perxeux0/TIMBRE_VER_2/hardware/caja_timbre_v1.stl

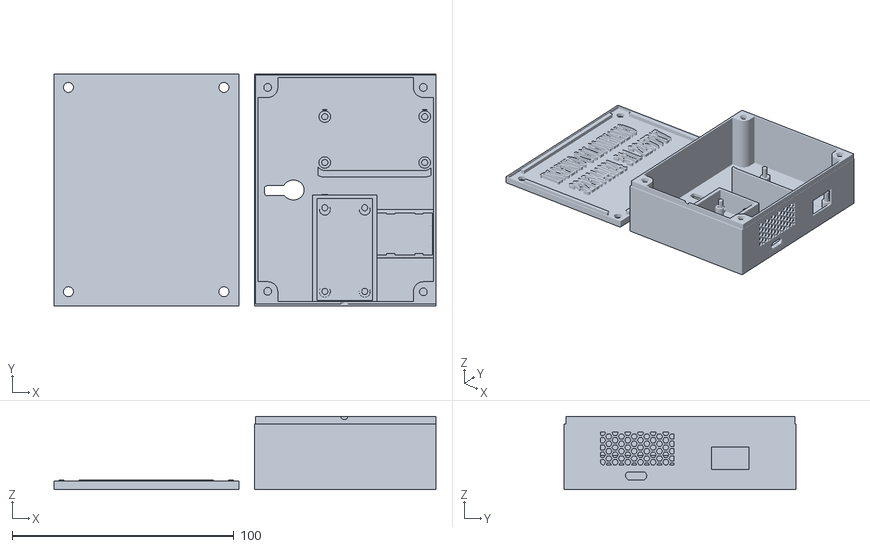
[picture p1: CAD file, 2026-10-14]
hardware/caja_timbre_v1.stl
172.4 x 104.6 x 33.0
