perxeux0/TIMBRE_VER_2/firmware/Timbre_Alba_V2/web_assets.h

#pragma once
// ARCHIVO GENERADO por tools/build_web.py - no editar a mano.
// Fuente: carpeta web/ (index.html, app.css, app.js)
#include <Arduino.h>
static const char WEB_ETAG[] = "\"5afd2a3bb6286d9f\"";

static const uint8_t WEB_INDEX_GZ[] PROGMEM = {
  0x1f,0x8b,0x08,0x00,0x00,0x00,0x00,0x00,0x02,0xff,0xb5,0x58,0xc1,0x6e,0xdc,0x36,0x10,0xbd,0xfb,0x2b,
  0x18,0xf6,0x6a,0x79,0x6d,0x37,0x28,0x7a,0xd0,0x6e,0x61,0x18,0x68,0xd1,0xa2,0x2d,0x82,0xba,0x45,0xcf,
  0x94,0x34,0xde,0x65,0x4d,0x91,0x0a,0x49,0xad,0xb3,0xf9,0xa3,0x1e,0x7a,0x08,0x72,0x28,0x90,0x63,0xfd,
  0x63,0x7d,0x23,0x4a,0x2b,0x69,0xbd,0x49,0x9a,0xd6,0x3d,0xc4,0x5a,0x92,0xc3,0xe1,0xcc,0x9b,0x99,0x37,
  0x64,0xf2,0x67,0x95,0x2b,0xe3,0xae,0x21,0xb1,0x89,0xb5,0x59,0x9d,0xe4,0xfc,0x11,0x46,0xd9,0xf5,0x52,
  0x52,0x90,0x3c,0x41,0xaa,0xc2,0xa7,0xa6,0xa8,0x44,0xb9,0x51,0x3e,0x50,0x5c,0xca,0x36,0xde,0x66,0x5f,
  0xca,0x61,0xda,0xaa,0x9a,0x96,0x72,0xab,0xe9,0xbe,0x71,0x3e,0x4a,0x51,0x3a,0x1b,0xc9,0x42,0xec,0x5e,
  0x57,0x71,0xb3,0xac,0x68,0xab,0x4b,0xca,0xba,0xc1,0xa9,0xb6,0x3a,0x6a,0x65,0xb2,0x50,0x2a,0x43,0xcb,
  0x8b,0xd3,0x61,0x57,0x76,0xab,0xe3,0xb2,0x74,0x5b,0xf2,0x07,0x6a,0xe3,0x86,0x6a,0xca,0x4a,0x67,0x9c,
  0x9f,0x68,0xfe,0xec,0xe2,0xfc,0xf2,0xf9,0xe7,0xea,0x40,0xd6,0xd3,0x2d,0x79,0x4f,0x53,0x41,0xeb,0xb2,
  0xfd,0x2c,0x84,0xa3,0x8e,0x86,0x56,0x3f,0xeb,0xba,0xf0,0x24,0xae,0x4c,0xa1,0xf2,0x45,0x9a,0x3a,0xc9,
  0x8d,0xb6,0x77,0xc2,0x93,0x59,0xca,0x10,0x77,0x86,0xc2,0x86,0x08,0xbe,0x6c,0xb0,0x7b,0x29,0x17,0xaa,
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
  0xa2,0x0d,0xef,0x81,0xe0,0x40,0xb1,0x9e,0x51,0x53,0x76,0xf9,0xe4,0x21,0x43,0x2f,0xae,0xf1,0x38,0xc0,
  0x3d,0x70,0x0e,0xb6,0xc4,0x1d,0x6f,0x4b,0x6c,0x89,0x75,0x31,0xc4,0x7f,0x46,0x62,0x7d,0xb2,0x2e,0x6e,
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
};
static const size_t WEB_JS_GZ_LEN = 18153;
