perxeux0/TIMBRE_VER_2/(commit log)

2026-10-14 Timbre Alba V2: firmware con roles, historial, copias cifradas, Apps Script y panel web
    - Firmware ESP32-C3 con sesiones seguras, PBKDF2 y roles admin/usuario
    - Panel web embebido por roles, horarios por día, timbre manual
    - Historial de auditoría, copias de seguridad AES-256-GCM y restauración
    - Apps Script: carpeta TIMBRE_VER:2 en Drive, Sheets con firma HMAC
    - Sin secretos en el repositorio (secrets.h excluido)
    Claude-Session: https://claude.ai/code/session_01WuqPGpeZXvXiu9qdsbAPmN
2026-10-14 CI: comparar ETag de la interfaz en vez de bytes gzip
    Distintas versiones de zlib generan bytes distintos para el mismo
    contenido; el ETag (SHA-256 de web/) es la comparación correcta.
    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
2026-10-14 Demo del panel en GitHub Pages (demo/) con API simulada en el navegador
    - tools/demo/demo-api.js imita las rutas /api del firmware: roles,
    cambio de clave obligatorio, horarios, historial y copias cifradas
    (mismo formato AES-256-GCM que la placa, vía WebCrypto)
    - tools/build_demo.py genera demo/ desde web/ (una sola fuente)
    - CI verifica que demo/ esté al día; README enlaza la demo
    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
